VaticanUK/virtual-weasley-clock/Physical Clock/Frame_28BYJ48_Main_Mounting_Plate_120mm.stl

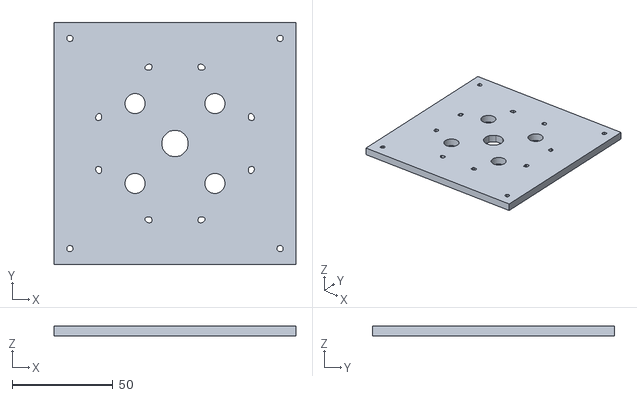
[picture p1: CAD file, 2026-11-07]
Physical Clock/Frame_28BYJ48_Main_Mounting_Plate_120mm.stl
120.0 x 120.0 x 5.00
