VaticanUK/virtual-weasley-clock/Physical Clock/Gear_Shaft4_Outer_5.0mm_60T.stl

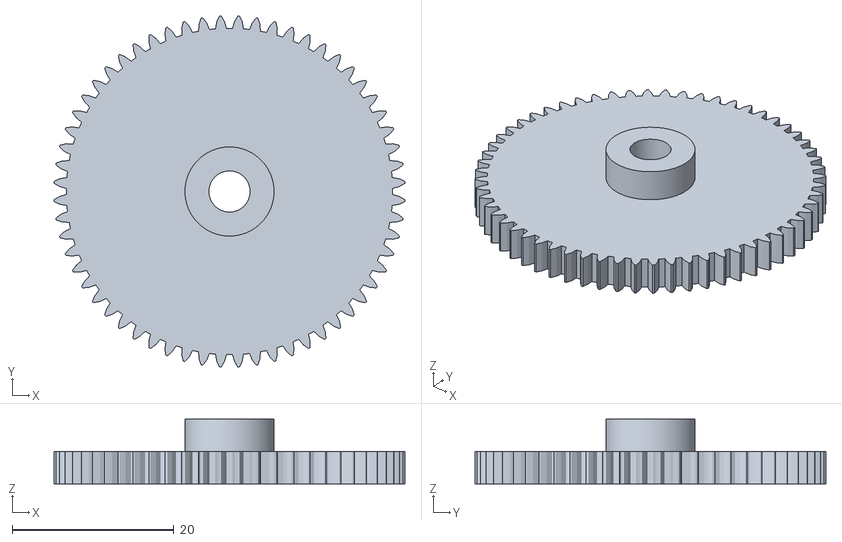
[picture p2: CAD file, 2026-11-07]
Physical Clock/Gear_Shaft4_Outer_5.0mm_60T.stl
43.4 x 43.4 x 8.00
