VaticanUK/virtual-weasley-clock/Physical Clock/Motor_Z_Spacer_Shaft1_25.5mm.stl

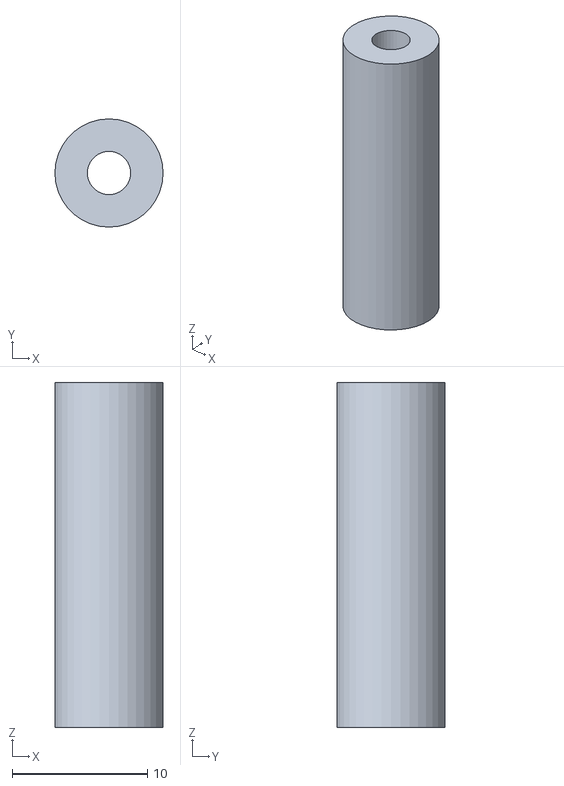
[picture p3: CAD file, 2026-11-07]
Physical Clock/Motor_Z_Spacer_Shaft1_25.5mm.stl
8.00 x 8.00 x 25.5
