VaticanUK/virtual-weasley-clock/Physical Clock/Clock_Hand_2_Inner_3.0mmBore.stl

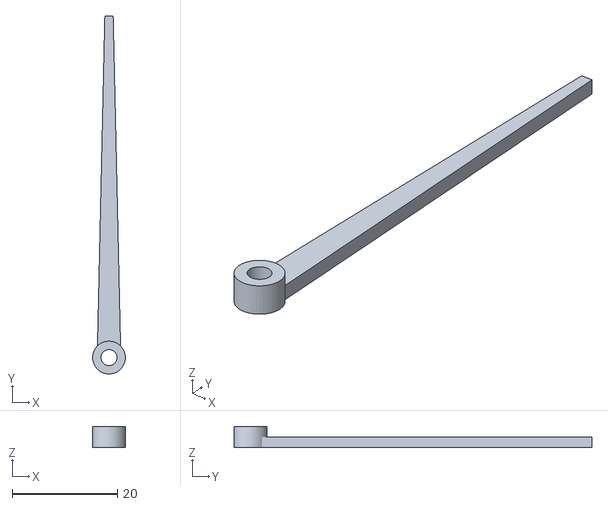
[picture p4: CAD file, 2026-11-07]
Physical Clock/Clock_Hand_2_Inner_3.0mmBore.stl
6.25 x 68.1 x 4.00
