VaticanUK/virtual-weasley-clock/Physical Clock/Clock_Hand_3_Mid_4.0mmBore.stl

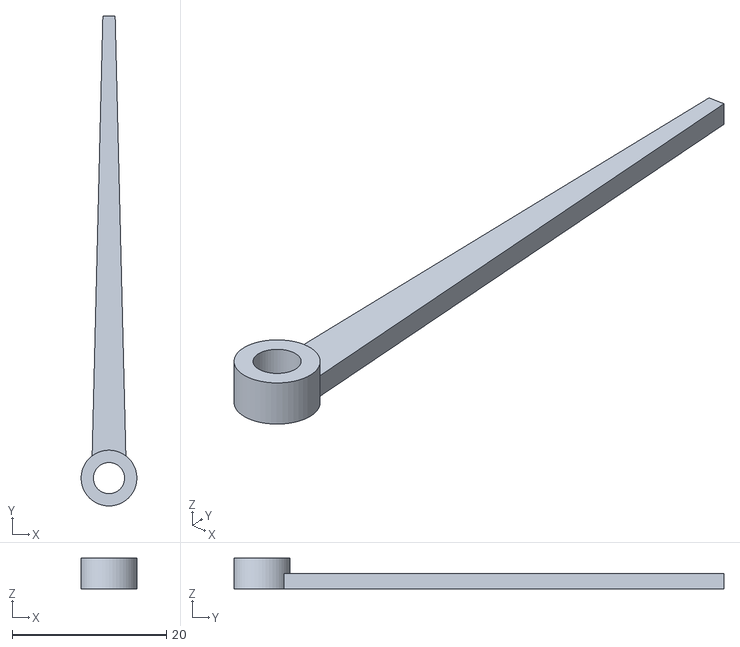
[picture p5: CAD file, 2026-11-07]
Physical Clock/Clock_Hand_3_Mid_4.0mmBore.stl
7.25 x 63.6 x 4.00
