VaticanUK/virtual-weasley-clock/Physical Clock/Gear_Shaft1_Core_2.0mm_60T.stl

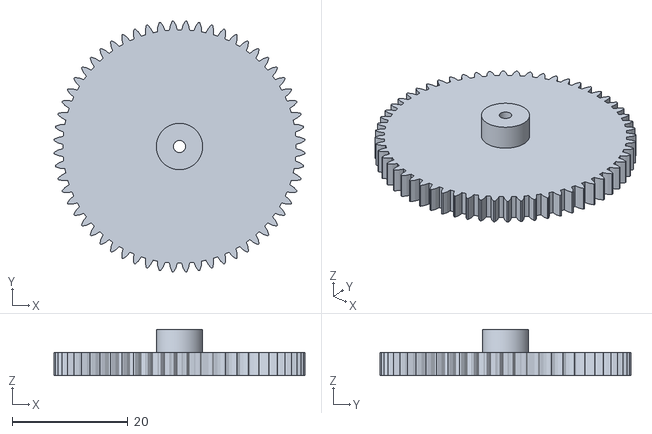
[picture p6: CAD file, 2026-11-07]
Physical Clock/Gear_Shaft1_Core_2.0mm_60T.stl
43.4 x 43.4 x 8.00
