VaticanUK/virtual-weasley-clock/Physical Clock/Clock_Hand_1_Core_2.0mmBore.stl

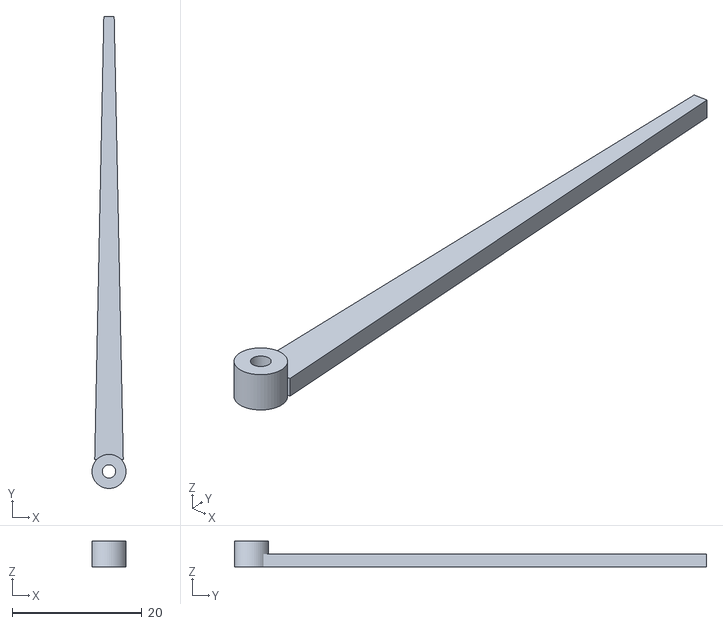
[picture p7: CAD file, 2026-11-07]
Physical Clock/Clock_Hand_1_Core_2.0mmBore.stl
5.25 x 72.6 x 4.00
