VaticanUK/virtual-weasley-clock/Physical Clock/Pinion_28BYJ48_20T_5mm_D_Shaft.stl

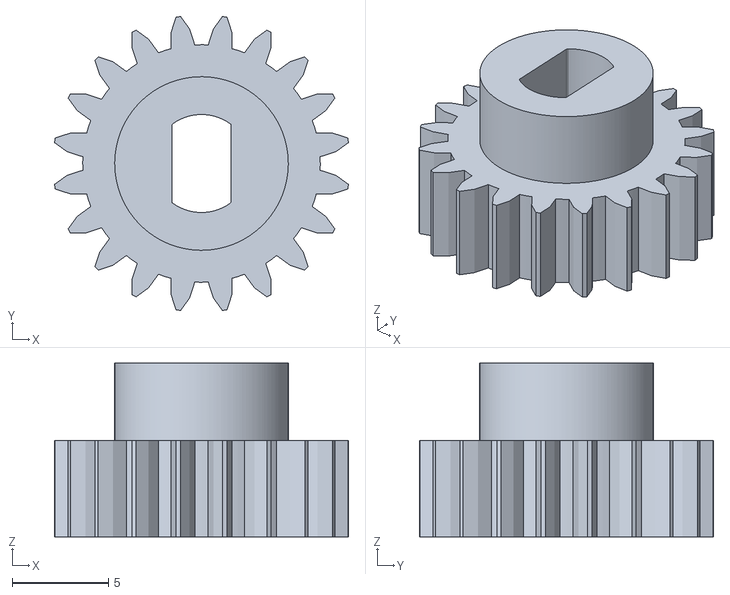
[picture p8: CAD file, 2026-11-07]
Physical Clock/Pinion_28BYJ48_20T_5mm_D_Shaft.stl
15.2 x 15.2 x 9.00
