VaticanUK/virtual-weasley-clock/Physical Clock/Motor_Z_Spacer_Shaft2_17.0mm.stl

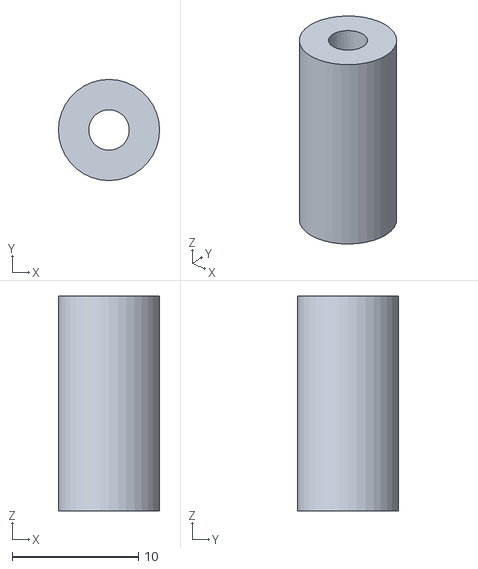
[picture p9: CAD file, 2026-11-07]
Physical Clock/Motor_Z_Spacer_Shaft2_17.0mm.stl
8.00 x 8.00 x 17.0
