VaticanUK/virtual-weasley-clock/Physical Clock/Bearing_Adapter_Sleeve_5mm_to_6mm.stl

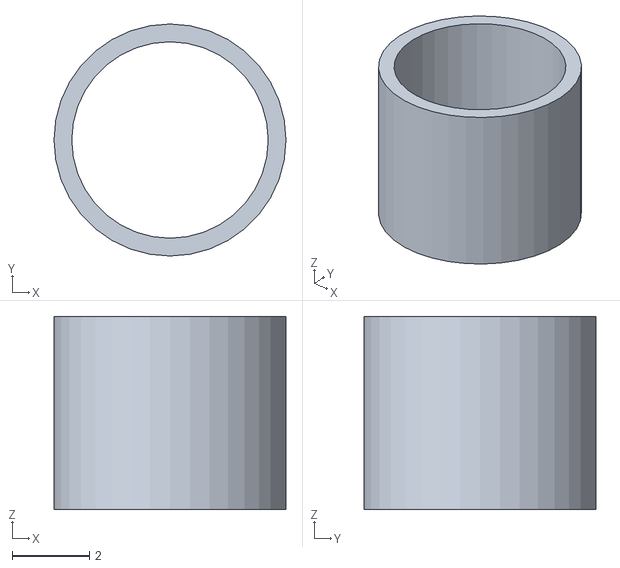
[picture p10: CAD file, 2026-11-07]
Physical Clock/Bearing_Adapter_Sleeve_5mm_to_6mm.stl
6.00 x 6.00 x 5.00
