VaticanUK/virtual-weasley-clock/Physical Clock/Motor_Z_Spacer_Shaft3_8.5mm.stl

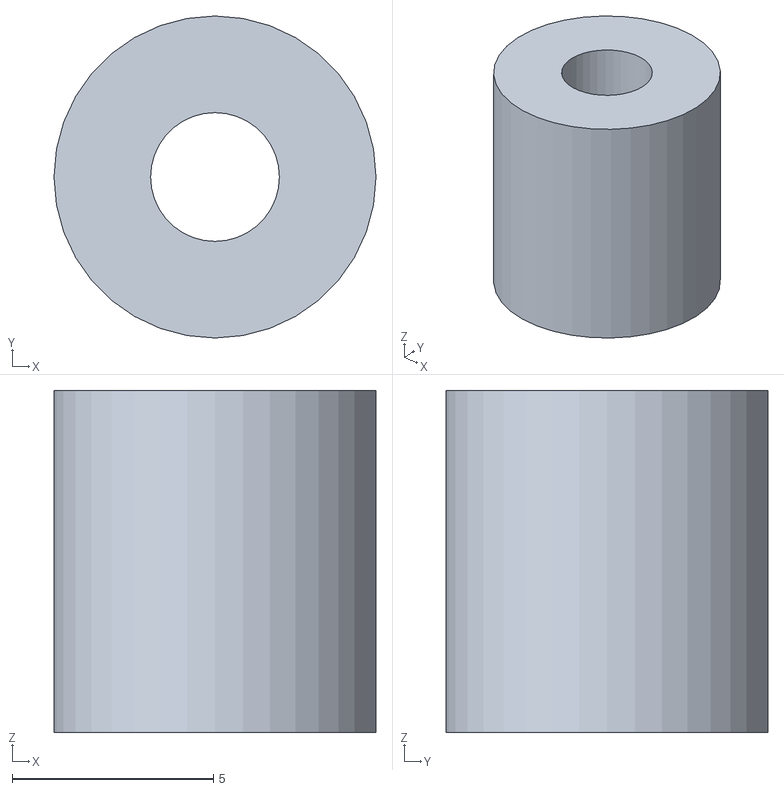
[picture p11: CAD file, 2026-11-07]
Physical Clock/Motor_Z_Spacer_Shaft3_8.5mm.stl
8.00 x 8.00 x 8.50
