VaticanUK/virtual-weasley-clock/Physical Clock/Clock_Hand_4_Outer_5.0mmBore.stl

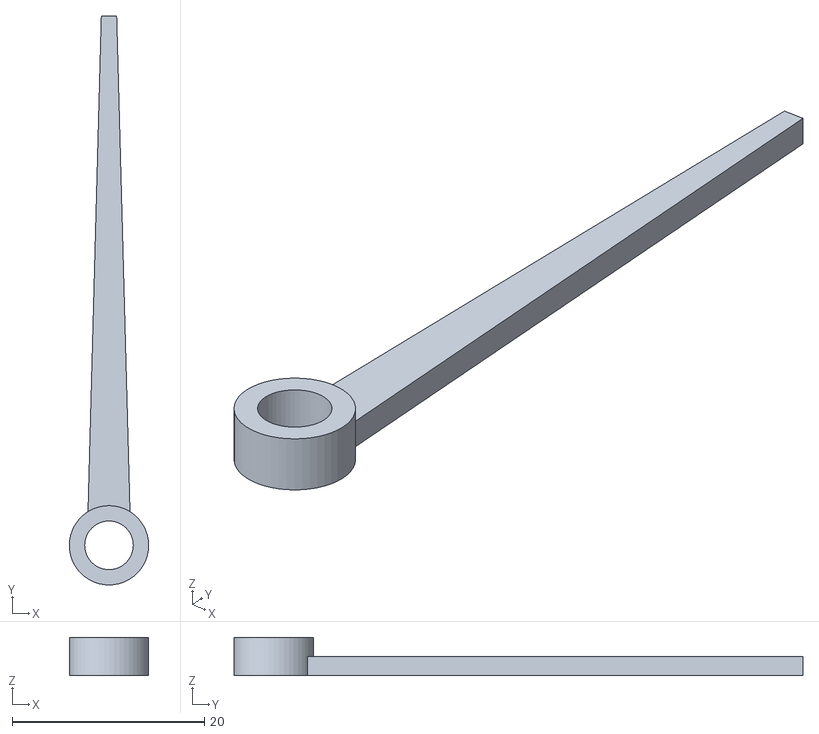
[picture p12: CAD file, 2026-11-07]
Physical Clock/Clock_Hand_4_Outer_5.0mmBore.stl
8.25 x 59.1 x 4.00
