VaticanUK/virtual-weasley-clock/Physical Clock/Frame_Corner_Pillar_35mm.stl

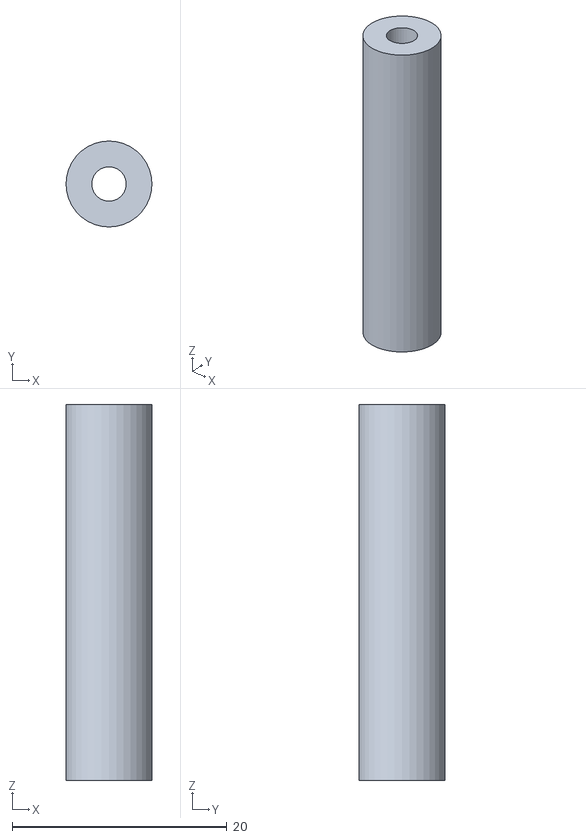
[picture p13: CAD file, 2026-11-07]
Physical Clock/Frame_Corner_Pillar_35mm.stl
8.00 x 8.00 x 35.0
