VaticanUK/virtual-weasley-clock/(list of files, cad)

Other CAD files:
Physical Clock/Gear_Shaft3_Mid_4.0mm_60T.stl
Physical Clock/Gear_Shaft2_Inner_3.0mm_60T.stl
